ainnajib2002/superbot_ws/Schematic System/schematic.png

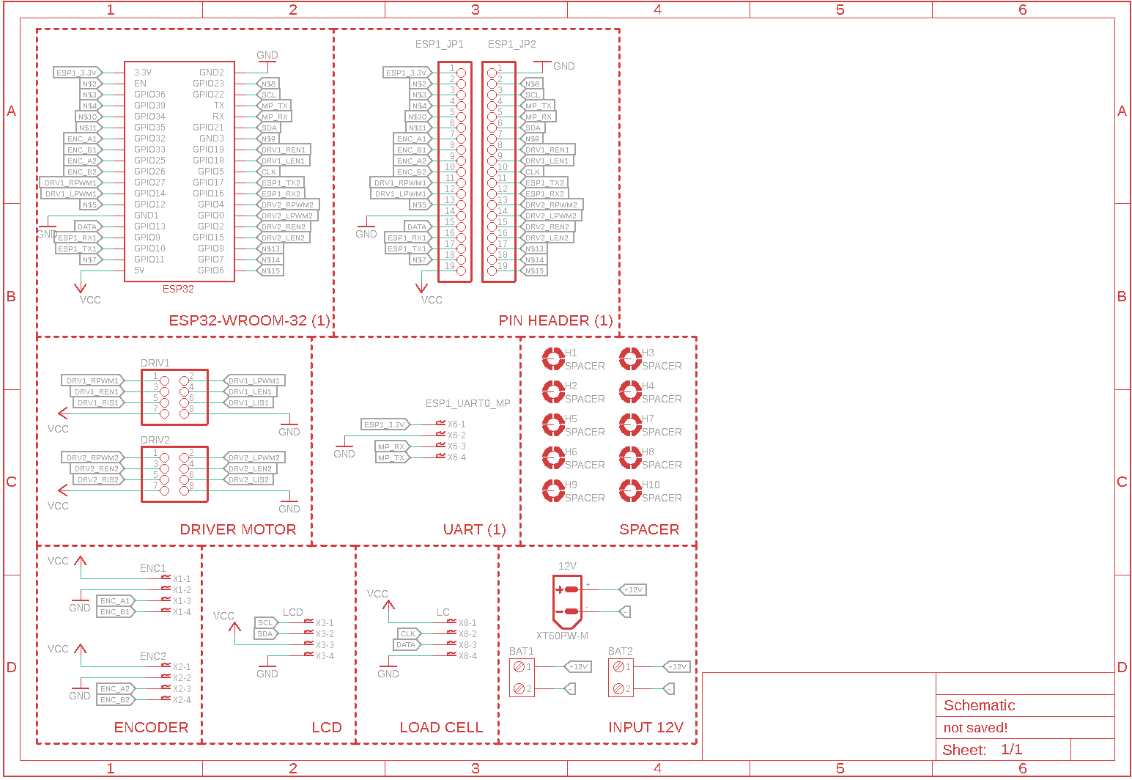
Schematic System/schematic.png
