ainnajib2002/superbot_ws/Schematic System/skematik_baru.png

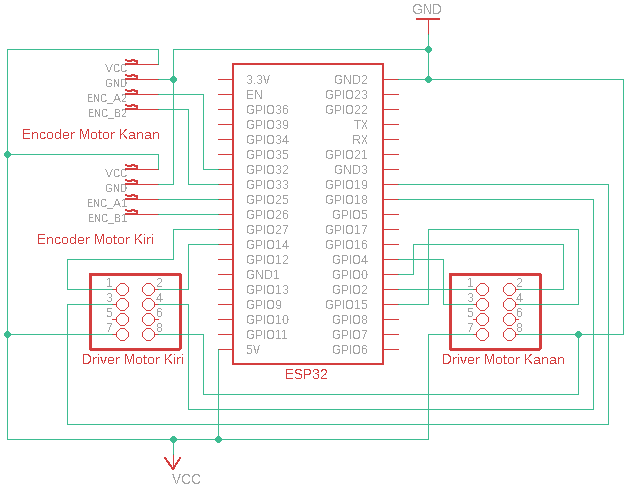
Schematic System/skematik_baru.png
