ainnajib2002/superbot_ws/Schematic System/tampak atas.png

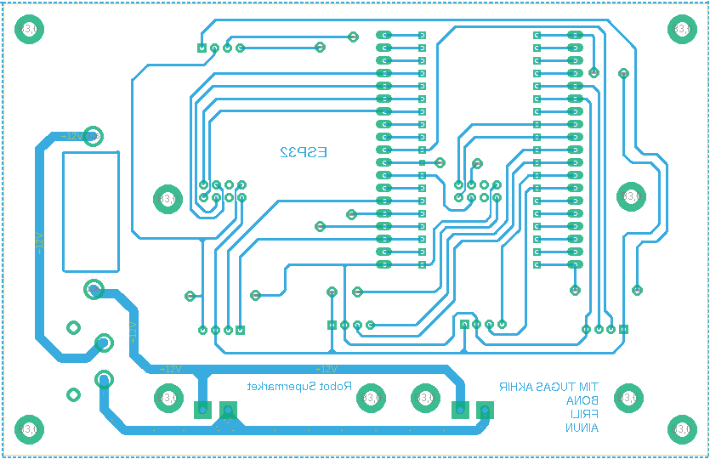
Schematic System/tampak atas.png
