ainnajib2002/superbot_ws/Schematic System/tampak bawah.png

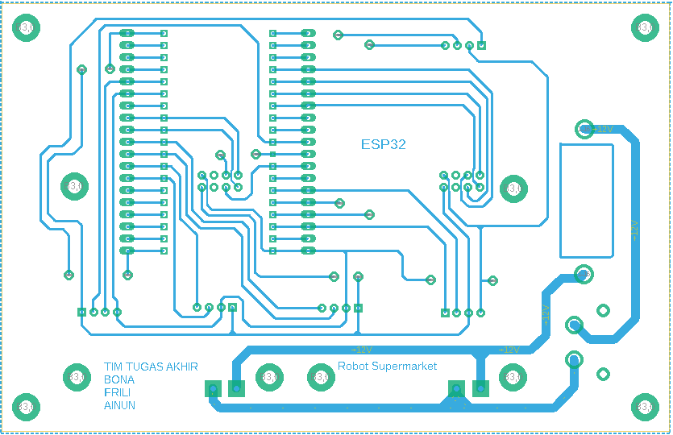
Schematic System/tampak bawah.png
