ainnajib2002/superbot_ws/src/superbot_core/superbot.png

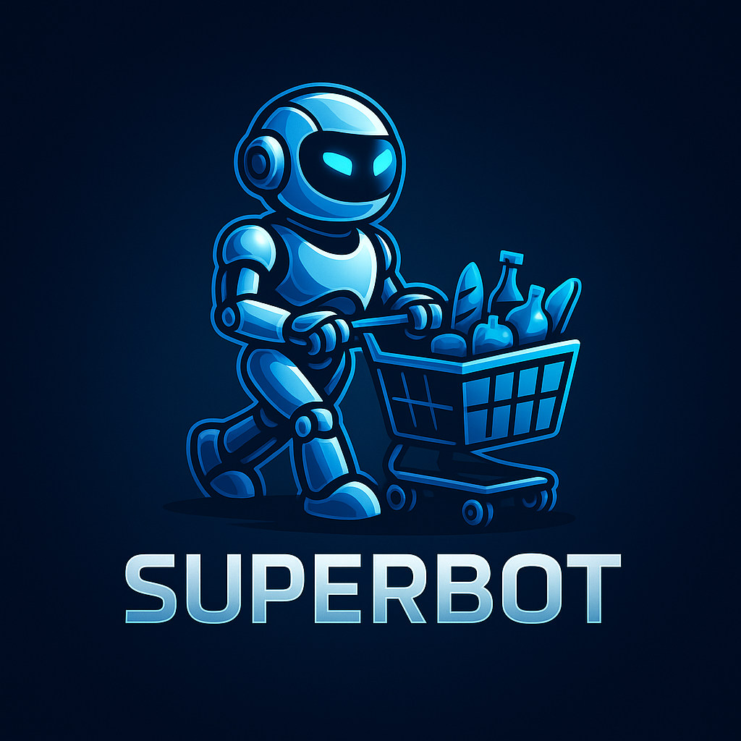
src/superbot_core/superbot.png
