ainnajib2002/superbot_ws/src/superbot_core/description/robot_core.xacro

<?xml version="1.0"?>

<robot xmlns:xacro="http://www.ros.org/wiki/xacro" >


<xacro:include filename="inertial_macros.xacro"/>

    <xacro:property name="chassis_length" value="0.51"/>
    <xacro:property name="chassis_width" value="0.51"/>
    <xacro:property name="chassis_height" value="0.22"/>
    <xacro:property name="chassis_mass" value="25.0"/>
    <xacro:property name="wheel_radius" value="0.05"/> <!--jari jari roda-->
    <xacro:property name="wheel_thickness" value="0.02"/>
    <xacro:property name="wheel_mass" value="0.1"/>
    <xacro:property name="wheel_offset_x" value="-0.03"/>
    <xacro:property name="wheel_offset_y" value="0.18"/>
    <xacro:property name="wheel_offset_z" value="0"/>
    <xacro:property name="caster_wheel_radius" value="0.05"/>
    <xacro:property name="caster_wheel_mass" value="0.1"/>
    <xacro:property name="caster_wheel_offset_x" value="0.1"/>
    <xacro:property name="caster_wheel_offset_z" value="${wheel_offset_z - wheel_radius + caster_wheel_radius}"/>

    <material name="white">
        <color rgba="1 1 1 1" />
    </material>

    <material name="orange">
        <color rgba="1 0.3 0.1 1"/>
    </material>

    <material name="blue">
        <color rgba="0.2 0.2 1 1"/>
    </material>

    <material name="black">
        <color rgba="0 0 0 1"/>
    </material>
    
    <material name="purple">
        <color rgba="0.5 0.0 0.5 1"/> <!-- ungu -->
    </material>
    
    <material name="green">
        <color rgba="0.0 1.0 0.0 1"/> <!-- hijau -->
    </material>
    
    <!-- BASE LINK -->

    <link name="base_link">
    </link>

    <!-- BASE_FOOTPRINT LINK -->

    <joint name="base_footprint_joint" type="fixed">
        <parent link="base_link"/>
        <child link="base_footprint"/>
        <origin xyz="0 0 0" rpy="0 0 0"/>
    </joint>

    <link name="base_footprint">
    </link>

    <!-- CHASSIS LINK -->

    <joint name="chassis_joint" type="fixed">
        <parent link="base_link"/>
        <child link="chassis"/>
        <origin xyz="-0.47 0 0"/>
    </joint>

    <link name="chassis">
        <visual>
            <origin xyz="0.255 0 0.11"/>
            <geometry>
                <box size="${chassis_length} ${chassis_width} ${chassis_height}"/> <!-- pxlxt kotak bawah-->
            </geometry>
            <material name="orange"/>
        </visual>
        <collision>
            <origin xyz="0.255 0 0.11"/>
            <geometry>
                <box size="${chassis_length} ${chassis_width} ${chassis_height}"/>
            </geometry>
        </collision>
        <xacro:inertial_box mass="${chassis_mass}" x="${chassis_length}" y="${chassis_width}" z="${chassis_height}">
            <origin xyz="0.255 0 0.11" rpy="0 0 0"/>
        </xacro:inertial_box>
    </link>

    <gazebo reference="chassis">
        <material>Gazebo/Orange</material>
    </gazebo>

    <!-- BODY LINK -->
    <joint name="body_joint" type="fixed">
        <parent link="chassis"/>
        <child link="body"/>
        <origin xyz="0.25 0 0.56"/> <!-- 0.22 (tinggi chassis) / 2 + 0.9 / 2 = 0.11 + 0.45 = 0.56 -->
    </joint>

    <link name="body">
        <visual>
            <origin xyz="0 0 -0.21"/>
            <geometry>
                <box size="0.45 0.5 0.27"/>
            </geometry>
            <material name="white"/>
        </visual>
        <collision>
            <origin xyz="0 0 0"/>
            <geometry>
                <box size="0.45 0.5 0.27"/>
            </geometry>
        </collision>
        <xacro:inertial_box mass="2.0" x="0.45" y="0.5" z="0.27">
            <origin xyz="0 0 0" rpy="0 0 0"/>
        </xacro:inertial_box>
    </link>

    <gazebo reference="body">
        <material>Gazebo/White</material>
    </gazebo>

    <!-- SMALL UPPER FRONT BODY LINK -->

    <joint name="small_upper_body_joint" type="fixed">
        <parent link="body"/>
        <child link="small_upper_body"/>
        <origin xyz="-0.23 0 0.22"/>
    </joint>

    <link name="small_upper_body">
        <visual>
            <geometry>
                <box size="0.05 0.15 0.1"/> <!-- panjang x, lebar y, tinggi z -->
            </geometry>
            <material name="purple"/>
        </visual>
        <collision>
            <geometry>
                <box size="0.05 0.15 0.1"/>
            </geometry>
        </collision>
        <xacro:inertial_box mass="0.1" x="0.05" y="0.15" z="0.1">
            <origin xyz="0 0 0" rpy="0 0 0"/>
        </xacro:inertial_box>
    </link>

    <gazebo reference="small_upper_body">
        <material>Gazebo/Purple</material>
    </gazebo>

    <!-- TIANG DEPAN LINK -->
    <joint name="tiang_depan_joint" type="fixed">
        <parent link="chassis"/>
        <child link="tiang_depan"/>
        <origin xyz="0.492 0 0.575" rpy="0 0 0"/> <!-- pojok kiri belakang atas chassis -->
    </joint>

    <link name="tiang_depan">
        <visual>
            <origin xyz="0 0 0.05"/> <!-- tengah vertikal dari tiang -->
            <geometry>
                <box size="0.037 0.51 0.815"/>
            </geometry>
            <material name="green"/>
        </visual>
        <collision>
            <origin xyz="0 0 0.05"/>
            <geometry>
                <box size="0.037 0.51 0.815"/>
            </geometry>
        </collision>
        <xacro:inertial_box mass="0.2" x="0.037" y="0.51" z="0.815">
            <origin xyz="0 0 0.05" rpy="0 0 0"/>
        </xacro:inertial_box>
    </link>

    <gazebo reference="tiang_depan">
        <material>Gazebo/Green</material>
    </gazebo>

    <!-- TIANG BELAKANG LINK -->
    <joint name="tiang_belakang_joint" type="fixed">
        <parent link="chassis"/>
        <child link="tiang_belakang"/>
        <origin xyz="0.021 0 0.425" rpy="0 0 0"/> <!-- pojok kiri belakang atas chassis -->
    </joint>

    <link name="tiang_belakang">
        <visual>
            <origin xyz="0 0 0.05"/> <!-- tengah vertikal dari tiang -->
            <geometry>
                <box size="0.045 0.51 0.51"/>
            </geometry>
            <material name="green"/>
        </visual>
        <collision>
            <origin xyz="0 0 0.05"/>
            <geometry>
                <box size="0.045 0.51 0.51"/>
            </geometry>
        </collision>
        <xacro:inertial_box mass="0.2" x="0.045" y="0.51" z="0.51">
            <origin xyz="0 0 0.05" rpy="0 0 0"/>
        </xacro:inertial_box>
    </link>

    <gazebo reference="tiang_belakang">
        <material>Gazebo/Green</material>
    </gazebo>
    
    <!-- LEFT WHEEL LINK -->

    <joint name="left_wheel_joint" type="continuous">
        <parent link="base_link"/>
        <child link="left_wheel"/>
        <origin xyz="${wheel_offset_x} ${wheel_offset_y} ${wheel_offset_z}" rpy="-${pi/2} 0 -${pi/4}" /> <!-- rotasi roda-->
        <axis xyz="0 0 1"/>
    </joint>

    <link name="left_wheel">
        <visual>
            <geometry>
                <cylinder radius="${wheel_radius}" length="${wheel_thickness}"/>
            </geometry>
            <material name="blue"/>
        </visual>
        <collision>
            <geometry>
                <cylinder radius="${wheel_radius}" length="${wheel_thickness}"/>
            </geometry>
        </collision>
        <xacro:inertial_cylinder mass="${wheel_mass}" length="${wheel_thickness}" radius="${wheel_radius}">
            <origin xyz="0 0 0" rpy="0 0 0"/>
        </xacro:inertial_cylinder>
    </link>

    <gazebo reference="left_wheel">
        <material>Gazebo/Blue</material>
    </gazebo>

    <!-- RIGHT WHEEL LINK -->

    <joint name="right_wheel_joint" type="continuous">
        <parent link="base_link"/>
        <child link="right_wheel"/>
        <origin xyz="${wheel_offset_x} -${wheel_offset_y} ${wheel_offset_z}" rpy="${pi/2} 0 ${pi/4}" /> <!--{pi/4} -->
        <axis xyz="0 0 -1"/>
    </joint>

    <link name="right_wheel">
        <visual>
            <geometry>
                <cylinder radius="${wheel_radius}" length="${wheel_thickness}"/>
            </geometry>
            <material name="blue"/>
        </visual>
        <collision>
            <geometry>
                <cylinder radius="${wheel_radius}" length="${wheel_thickness}"/>
            </geometry>
        </collision>
        <xacro:inertial_cylinder mass="${wheel_mass}" length="${wheel_thickness}" radius="${wheel_radius}">
            <origin xyz="0 0 0" rpy="0 0 0"/>
        </xacro:inertial_cylinder>
    </link>

    <gazebo reference="right_wheel">
        <material>Gazebo/Blue</material>
    </gazebo>


    <!-- KIRI CASTER WHEEL LINK -->

    <joint name="left_caster_wheel_joint" type="fixed">
        <parent link="chassis"/>
        <child link="left_caster_wheel"/>
        <origin xyz="${caster_wheel_offset_x} ${wheel_offset_y} ${caster_wheel_offset_z}" rpy="-${pi/2} 0 0"/> <!-- orientasi silinder horizontal -->
    </joint>

    <link name="left_caster_wheel">
        <visual>
            <geometry>
                <cylinder radius="${caster_wheel_radius}" length="${wheel_thickness}"/>
            </geometry>
            <material name="black"/>
        </visual>
        <collision>
            <geometry>
                <cylinder radius="${caster_wheel_radius}" length="${wheel_thickness}"/>
            </geometry>
        </collision>
        <xacro:inertial_cylinder mass="${caster_wheel_mass}" length="${wheel_thickness}" radius="${caster_wheel_radius}">
            <origin xyz="0 0 0" rpy="0 0 0"/>
        </xacro:inertial_cylinder>
    </link>

    <gazebo reference="left_caster_wheel">
        <material>Gazebo/Black</material>
        <mu1 value="0.001"/>
        <mu2 value="0.001"/>
    </gazebo>


    <!-- KANAN CASTER WHEEL LINK -->

    <joint name="right_caster_wheel_joint" type="fixed">
        <parent link="chassis"/>
        <child link="right_caster_wheel"/>
        <origin xyz="${caster_wheel_offset_x} -${wheel_offset_y} ${caster_wheel_offset_z}" rpy="-${pi/2} 0 0"/> <!-- orientasi silinder horizontal -->
    </joint>

    <link name="right_caster_wheel">
        <visual>
            <geometry>
                <cylinder radius="${caster_wheel_radius}" length="${wheel_thickness}"/>
            </geometry>
            <material name="black"/>
        </visual>
        <collision>
            <geometry>
                <cylinder radius="${caster_wheel_radius}" length="${wheel_thickness}"/>
            </geometry>
        </collision>
        <xacro:inertial_cylinder mass="${caster_wheel_mass}" length="${wheel_thickness}" radius="${caster_wheel_radius}">
            <origin xyz="0 0 0" rpy="0 0 0"/>
        </xacro:inertial_cylinder>
    </link>

    <gazebo reference="right_caster_wheel">
        <material>Gazebo/Black</material>
        <mu1 value="0.001"/>
        <mu2 value="0.001"/>
    </gazebo>    

</robot>
