ainnajib2002/superbot_ws/Schematic System/Schematic.brd

## EAGLE design Schematic System/Schematic.brd (2025-08-28)

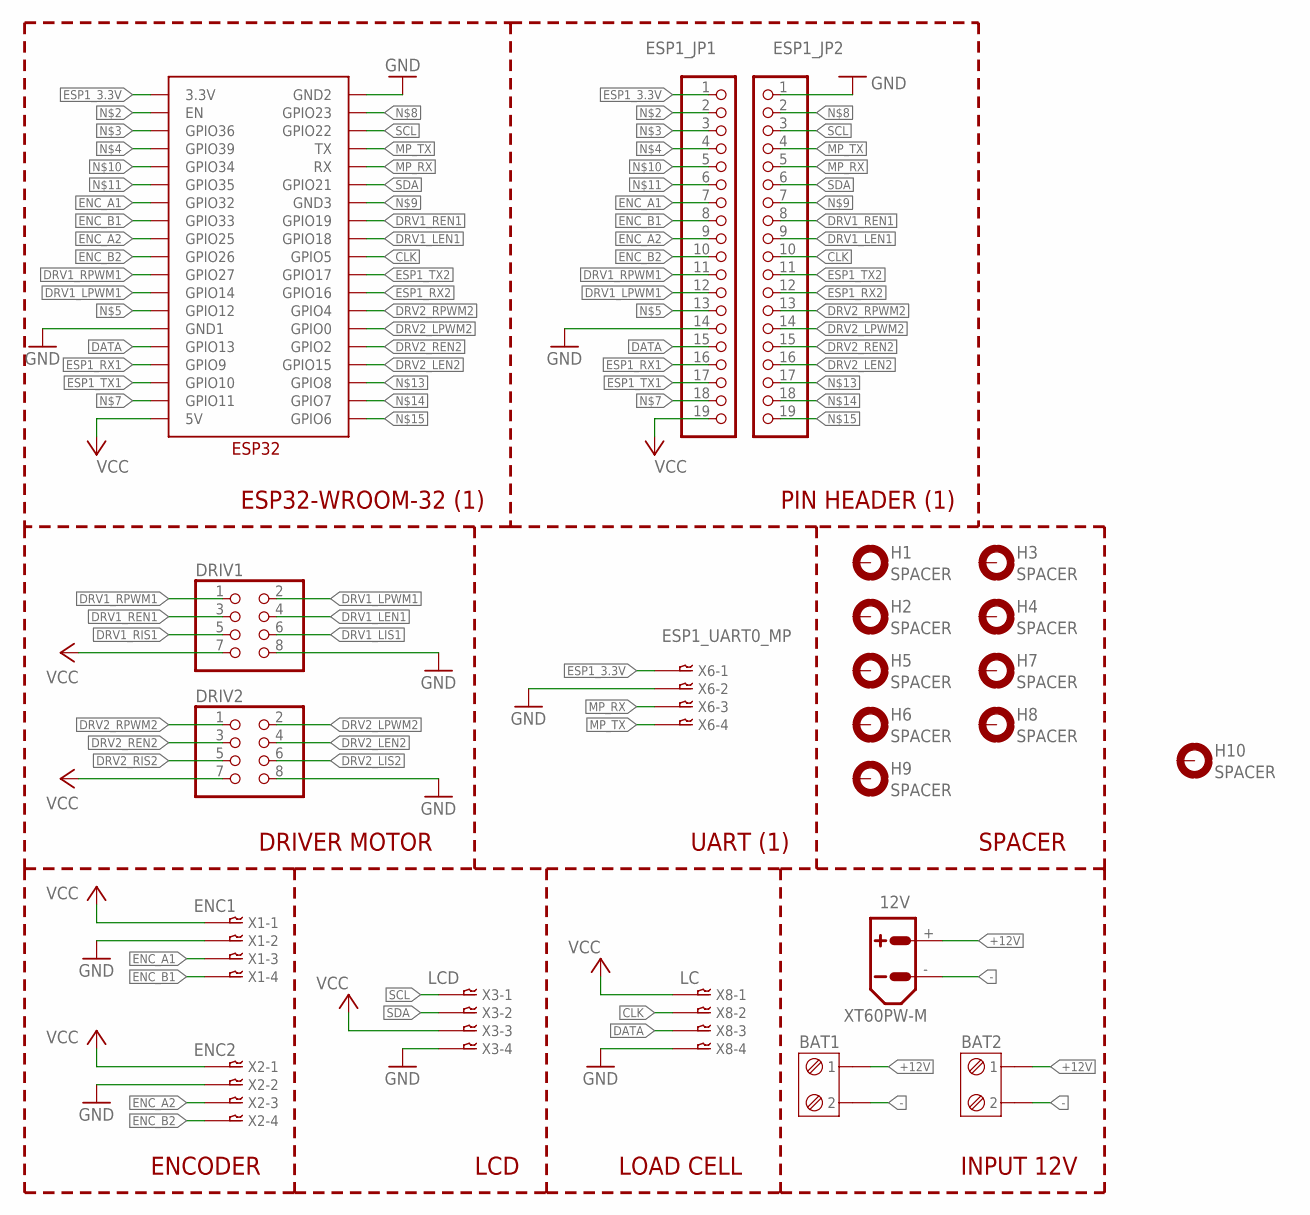
[picture p41: schematic Schematic.sch]

Parts:
12V: XT60PW-M
BAT1, BAT2: TERMINAL-BLOK-2P; TERMINAL_BLOK_2P
DRIV1, DRIV2: PINHD-2X4; 2X04
ESP1_JP1, ESP1_JP2: PINHD-1X19; 1X19
H1, H2, H3, H4, H5, H6, H7, H8, H9, H10: SPACER; 3,0-PAD
U$1: ESP32_GRBL
X1: ENC1; B4B-XH
X2: ENC2; B4B-XH
X3: LCD; B4B-XH
X6: ESP1_UART0_MP; B4B-XH
X8: LC; B4B-XH

Connections:
+12V: 12V.+, BAT1.1, BAT2.1
-: 12V.-, BAT1.2, BAT2.2
CLK: ESP1_JP2.10, U$1.GPIO5, X8.P$2
DATA: ESP1_JP1.15, U$1.GPIO13, X8.P$3
DRV1_LEN1: DRIV1.4, ESP1_JP2.9, U$1.GPIO18
DRV1_LIS1: DRIV1.6
DRV1_LPWM1: DRIV1.2, ESP1_JP1.12, U$1.GPIO14
DRV1_REN1: DRIV1.3, ESP1_JP2.8, U$1.GPIO19
DRV1_RIS1: DRIV1.5
DRV1_RPWM1: DRIV1.1, ESP1_JP1.11, U$1.GPIO27
DRV2_LEN2: DRIV2.4, ESP1_JP2.16, U$1.GPIO15
DRV2_LIS2: DRIV2.6
DRV2_LPWM2: DRIV2.2, ESP1_JP2.14, U$1.GPIO0
DRV2_REN2: DRIV2.3, ESP1_JP2.15, U$1.GPIO2
DRV2_RIS2: DRIV2.5
DRV2_RPWM2: DRIV2.1, ESP1_JP2.13, U$1.GPIO4
ENC_A1: ESP1_JP1.7, U$1.GPIO32, X1.P$3
ENC_A2: ESP1_JP1.9, U$1.GPIO25, X2.P$3
ENC_B1: ESP1_JP1.8, U$1.GPIO33, X1.P$4
ENC_B2: ESP1_JP1.10, U$1.GPIO26, X2.P$4
ESP1_3.3V: ESP1_JP1.1, U$1.3.3V, X6.P$1
ESP1_RX1: ESP1_JP1.16, U$1.GPIO9
ESP1_RX2: ESP1_JP2.12, U$1.GPIO16
ESP1_TX1: ESP1_JP1.17, U$1.GPIO10
ESP1_TX2: ESP1_JP2.11, U$1.GPIO17
GND: DRIV1.8, DRIV2.8, ESP1_JP1.14, ESP1_JP2.1, U$1.GND1, U$1.GND2, X1.P$2, X2.P$2, X3.P$4, X6.P$2, X8.P$4
MP_RX: ESP1_JP2.5, U$1.RX, X6.P$3
MP_TX: ESP1_JP2.4, U$1.TX, X6.P$4
unnamed: ESP1_JP1.2, U$1.EN
unnamed: ESP1_JP1.3, U$1.GPIO36
unnamed: ESP1_JP1.4, U$1.GPIO39
unnamed: ESP1_JP1.13, U$1.GPIO12
unnamed: ESP1_JP1.18, U$1.GPIO11
unnamed: ESP1_JP2.2, U$1.GPIO23
unnamed: ESP1_JP2.7, U$1.GND3
unnamed: ESP1_JP1.5, U$1.GPIO34
unnamed: ESP1_JP1.6, U$1.GPIO35
unnamed: ESP1_JP2.17, U$1.GPIO8
unnamed: ESP1_JP2.18, U$1.GPIO7
unnamed: ESP1_JP2.19, U$1.GPIO6
SCL: ESP1_JP2.3, U$1.GPIO22, X3.P$1
SDA: ESP1_JP2.6, U$1.GPIO21, X3.P$2
VCC: DRIV1.7, DRIV2.7, ESP1_JP1.19, U$1.5V, X1.P$1, X2.P$1, X3.P$3, X8.P$1

Notes on the sheet:
ESP32-WROOM-32 (1)
PIN HEADER (1)
DRIVER MOTOR
UART (1)
SPACER
INPUT 12V
ENCODER
LCD
LOAD CELL

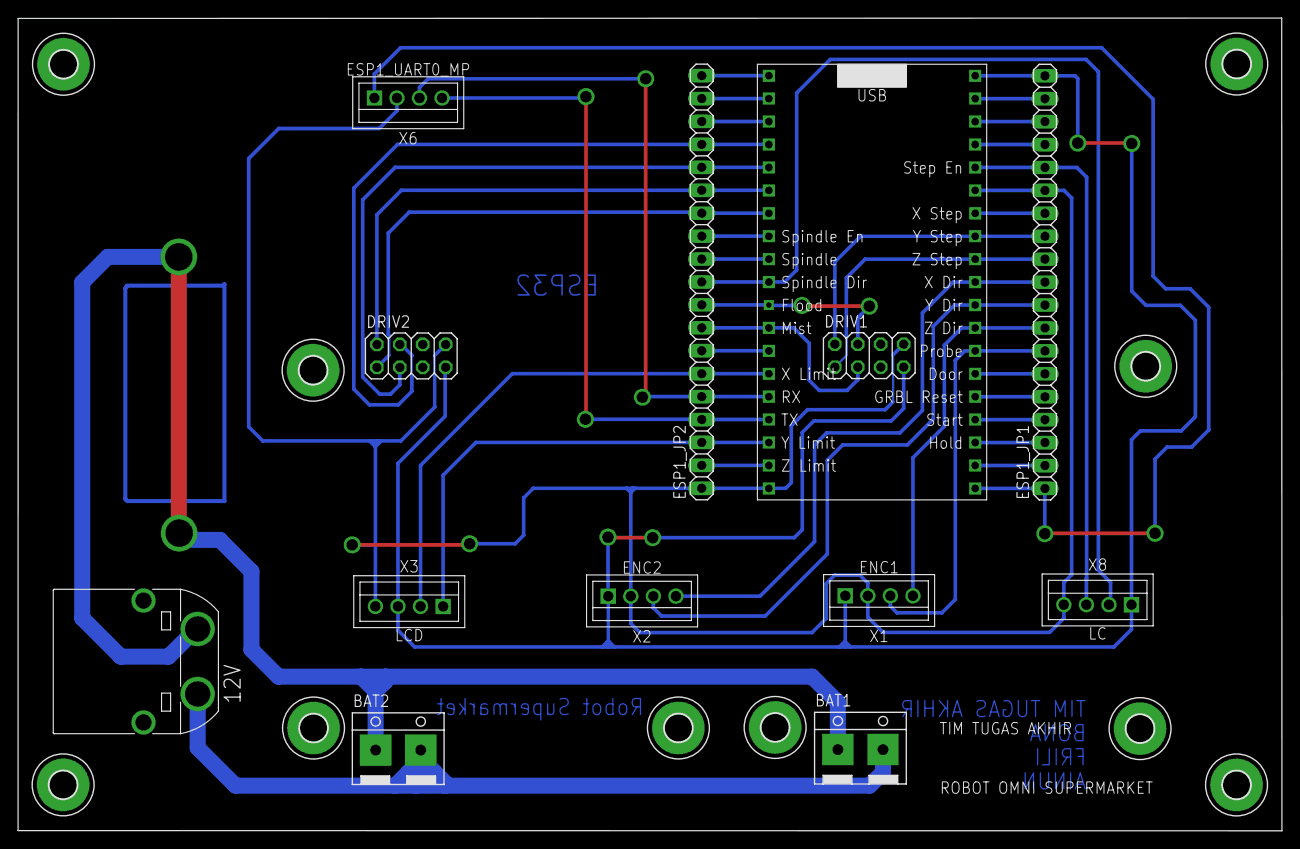
[picture p42: board Schematic.brd from above]

Board: 2 copper layers, 140.0 x 90.0 mm, 23 parts (0 on the bottom side), 39 nets.
