ainnajib2002/superbot_ws/src/superbot_hardware/config/superbot_controllers.yaml

controller_manager:
  ros__parameters:
    update_rate: 80  # Hz

    joint_state_broadcaster:
      type: joint_state_broadcaster/JointStateBroadcaster

    diffbot_base_controller:
      type: diff_drive_controller/DiffDriveController

diffbot_base_controller:
  ros__parameters:
    left_wheel_names: ["left_wheel_joint"]
    right_wheel_names: ["right_wheel_joint"]

    # wheel_separation: 0.10
    # #wheels_per_side: 1  # actually 2, but both are controlled by 1 signal
    # wheel_radius: 0.015
    wheel_separation: 0.30 #jarak antar roda 30cm
    wheel_radius: 0.05 #jari jari roda 5cm

    wheel_separation_multiplier: 1.0
    left_wheel_radius_multiplier: 1.1
    right_wheel_radius_multiplier: -1.1

    publish_rate: 50.0
    odom_frame_id: odom
    base_frame_id: base_link
    pose_covariance_diagonal : [0.001, 0.001, 0.001, 0.001, 0.001, 0.01]
    twist_covariance_diagonal: [0.001, 0.001, 0.001, 0.001, 0.001, 0.01]

    open_loop: false
    enable_odom_tf: true

    cmd_vel_timeout: 0.5
    publish_limited_velocity: true
    use_stamped_vel: false
    #velocity_rolling_window_size: 10

    linear.x.has_velocity_limits: true
    linear.x.has_acceleration_limits: true
    linear.x.has_jerk_limits: false
    linear.x.max_velocity: 0.25     # m/s
    linear.x.min_velocity: -0.25       
    linear.x.max_acceleration: 1.0    # m/s^2
    linear.x.min_acceleration: -1.0
    linear.x.max_jerk: 0.0            # m/s^3
    linear.x.min_jerk: 0.0            

    angular.z.has_velocity_limits: true
    angular.z.has_acceleration_limits: true
    angular.z.has_jerk_limits: false
    angular.z.max_velocity: 3.14        # rad/s
    angular.z.min_velocity: -3.14
    angular.z.max_acceleration: 1.28    # rad/s^2
    angular.z.min_acceleration: -1.28
    angular.z.max_jerk: 0.0             # rad/s^3
    angular.z.min_jerk: 0.0
