ainnajib2002/superbot_ws/src/superbot_core/txt/cgatparamsteb.yaml

amcl:
  ros__parameters:
    use_sim_time: False
    alpha1: 0.2
    alpha2: 0.2
    alpha3: 0.2
    alpha4: 0.2
    alpha5: 0.2
    base_frame_id: "base_footprint"
    beam_skip_distance: 0.5
    beam_skip_error_threshold: 0.9
    beam_skip_threshold: 0.3
    do_beamskip: false
    global_frame_id: "map"
    lambda_short: 0.1
    laser_likelihood_max_dist: 2.0
    laser_max_range: 100.0
    laser_min_range: -1.0
    laser_model_type: "likelihood_field"
    max_beams: 60
    max_particles: 3000 #2000
    min_particles: 1000 #500
    odom_frame_id: "odom"
    pf_err: 0.05 #Toleransi error rata-rata (0.05 artinya 5 cm) untuk menentukan jumlah partikel.
    pf_z: 0.99
    recovery_alpha_fast: 0.0
    recovery_alpha_slow: 0.0
    resample_interval: 1
    robot_model_type: "differential"
    save_pose_rate: 0.5
    sigma_hit: 0.2
    tf_broadcast: true
    transform_tolerance: 1.0
    update_min_a: 0.02 ##jika robot telah berputar sejauh x.xmeter.
    update_min_d: 0.025 # (2.5 cm)jika robot telah bergerak sejauh x.xm eter.
    z_hit: 0.5
    z_max: 0.05
    z_rand: 0.5
    z_short: 0.05
    scan_topic: scan
    set_initial_pose: true
    # always_reset_initial_pose: false
    # first_map_only: false
    initial_pose:
      x: 0.0
      y: 0.0
      z: 0.0
      yaw: 0.0

amcl_map_client:
  ros__parameters:
    use_sim_time: False

amcl_rclcpp_node:
  ros__parameters:
    use_sim_time: False

bt_navigator:
  ros__parameters:
    use_sim_time: False
    global_frame: map
    robot_base_frame: base_link
    odom_topic: /odom
    enable_groot_monitoring: True
    groot_zmq_publisher_port: 1666
    groot_zmq_server_port: 1667
    bt_loop_duration: 0.025
    default_server_timeout: 10 #Timeout dari BT (Behavior Tree)
    wait_for_service_timeout: 1000  # 1 detik
    action_server_result_timeout: 100.0  # menit
    default_bt_xml_filename: "/home/orin/superbot_ws/src/navigation2/nav2_bt_navigator/behavior_trees/navigate_w_replanning_and_recovery.xml"
    # navigators: ["navigate_to_pose", "navigate_through_poses"]
    # navigate_to_pose:/opt/ros/foxy/share/nav2_bt_navigator/behavior_trees/navigate_w_replanning_and_recovery.xml 
    #   plugin: "nav2_bt_navigator::NavigateToPoseNavigator"
    # navigate_through_poses:
    #   plugin: "nav2_bt_navigator::NavigateThroughPosesNavigator"
    plugin_lib_names:
    - nav2_compute_path_to_pose_action_bt_node
    - nav2_follow_path_action_bt_node
    - nav2_back_up_action_bt_node
    - nav2_spin_action_bt_node
    - nav2_wait_action_bt_node
    - nav2_clear_costmap_service_bt_node
    - nav2_is_stuck_condition_bt_node
    - nav2_goal_reached_condition_bt_node
    - nav2_goal_updated_condition_bt_node
    - nav2_initial_pose_received_condition_bt_node
    - nav2_reinitialize_global_localization_service_bt_node
    - nav2_rate_controller_bt_node
    - nav2_distance_controller_bt_node
    - nav2_speed_controller_bt_node
    - nav2_truncate_path_action_bt_node
    - nav2_goal_updater_node_bt_node
    - nav2_recovery_node_bt_node
    - nav2_pipeline_sequence_bt_node
    - nav2_round_robin_node_bt_node
    - nav2_transform_available_condition_bt_node
    - nav2_time_expired_condition_bt_node
    - nav2_distance_traveled_condition_bt_node
    - nav2_navigate_to_pose_action_bt_node

bt_navigator_rclcpp_node:
  ros__parameters:
    use_sim_time: False

controller_server:
  ros__parameters:
    odom_topic: /odom
    use_sim_time: True
    controller_frequency: 5.0
    controller_plugin_types: ["teb_local_planner::TebLocalPlannerROS"]
    controller_plugins: ["FollowPath"]
    
    # Progress checker parameters
    progress_checker:
      plugin: "nav2_controller::SimpleProgressChecker"
      required_movement_radius: 0.2
      movement_time_allowance: 40.0  # Batas waktu maksimum (dalam detik) yang diizinkan untuk robot bergerak sebelum dianggap gagal.
    
    # Goal checker parameters
    goal_checker:
      plugin: "nav2_controller::SimpleGoalChecker"
      xy_goal_tolerance: 0.15
      yaw_goal_tolerance: 0.15
      stateful: True

    # TEB parameters
    FollowPath:
      plugin: teb_local_planner::TebLocalPlannerROS

      teb_autosize: 1.0
      dt_ref: 0.3
      dt_hysteresis: 0.1
      max_samples: 500
      global_plan_overwrite_orientation: False
      allow_init_with_backwards_motion: False
      max_global_plan_lookahead_dist: 3.0
      global_plan_viapoint_sep: 0.3
      global_plan_prune_distance: 1.0
      exact_arc_length: False
      feasibility_check_no_poses: 2
      publish_feedback: False

      # Robot
      max_vel_x: 0.26
      max_vel_theta: 1.0 
      acc_lim_x: 2.5
      acc_lim_theta: 3.2

      footprint_model: 
        type: "circular"
        radius: 0.17 # for type "circular"

      # Goal Tolerance
      free_goal_vel: False

      # Obstacles
      min_obstacle_dist: 0.27
      inflation_dist: 0.6
      include_costmap_obstacles: True
      costmap_obstacles_behind_robot_dist: 1.0
      obstacle_poses_affected: 15

      dynamic_obstacle_inflation_dist: 0.6
      include_dynamic_obstacles: True 

      costmap_converter_plugin: "costmap_converter::CostmapToPolygonsDBSMCCH"
      costmap_converter_spin_thread: True
      costmap_converter_rate: 5

      # Optimization
      no_inner_iterations: 5
      no_outer_iterations: 4
      optimization_activate: True
      optimization_verbose: False
      penalty_epsilon: 0.1
      obstacle_cost_exponent: 4.0
      weight_max_vel_x: 0.5
      weight_max_vel_theta: 0.5
      weight_acc_lim_x: 0.5
      weight_acc_lim_theta: 10.5
      weight_kinematics_nh: 1000.0
      weight_kinematics_forward_drive: 3.0
      weight_kinematics_turning_radius: 1.0
      weight_optimaltime: 1.0 # must be > 0
      weight_shortest_path: 0.0
      weight_obstacle: 100.0
      weight_inflation: 0.2
      weight_dynamic_obstacle: 10.0 # not in use yet
      weight_dynamic_obstacle_inflation: 0.2
      weight_viapoint: 50.0
      weight_adapt_factor: 2.0

      # Homotopy Class Planner
      enable_homotopy_class_planning: True
      enable_multithreading: True
      max_number_classes: 4
      selection_cost_hysteresis: 5.0
      selection_prefer_initial_plan: 1.0
      selection_obst_cost_scale: 1.0
      selection_alternative_time_cost: True

      roadmap_graph_no_samples: 15
      roadmap_graph_area_width: 5.0
      roadmap_graph_area_length_scale: 1.0
      h_signature_prescaler: 0.5
      h_signature_threshold: 0.1
      obstacle_heading_threshold: 0.45
      switching_blocking_period: 0.0
      viapoints_all_candidates: True
      delete_detours_backwards: True
      max_ratio_detours_duration_best_duration: 3.0
      visualize_hc_graph: False
      visualize_with_time_as_z_axis_scale: 0.0

      # Recovery
      shrink_horizon_backup: True
      shrink_horizon_min_duration: 10.0
      oscillation_recovery: True
      oscillation_v_eps: 0.1
      oscillation_omega_eps: 0.1
      oscillation_recovery_min_duration: 10.0
      oscillation_filter_duration: 10.0


controller_server_rclcpp_node:
  ros__parameters:
    use_sim_time: False

# planner_server:
#   ros__parameters:
#     use_sim_time: False
#     planner_plugins: ["GridBased"]
#     GridBased:
#       plugin: "nav2_navfn_planner/NavfnPlanner"

local_costmap:
  local_costmap:
    ros__parameters:
      update_frequency: 5.0
      publish_frequency: 2.0
      global_frame: odom
      robot_base_frame: base_link
      use_sim_time: False
      rolling_window: true
      width: 5
      height: 5
      resolution: 0.05
      robot_radius: 0.42 # ukuran robot (untuk memastikan robot tidak menabrak rintangan) 52 cm
      plugins: ["static_layer","voxel_layer", "inflation_layer"]
      inflation_layer:
        plugin: "nav2_costmap_2d::InflationLayer"
        cost_scaling_factor: 6.5     # cukup agresif tapi tidak berlebihan
        inflation_radius: 0.87        # aman untuk robot sedang, jarak menghindar cukup
      voxel_layer:
        plugin: "nav2_costmap_2d::VoxelLayer"
        enabled: True
        publish_voxel_map: True
        origin_z: 0.0
        z_resolution: 0.05
        z_voxels: 16
        max_obstacle_height: 2.0
        mark_threshold: 0
        observation_sources: scan
        scan:
          topic: /scan
          max_obstacle_height: 2.0
          clearing: True
          marking: True
          data_type: "LaserScan"
      static_layer:
        plugin: "nav2_costmap_2d::StaticLayer"
        map_subscribe_transient_local: True
      always_send_full_costmap: True
  local_costmap_client:
    ros__parameters:
      use_sim_time: False
  local_costmap_rclcpp_node:
    ros__parameters:
      use_sim_time: False

global_costmap:
  global_costmap:
    ros__parameters:
      update_frequency: 5.0
      publish_frequency: 2.0
      global_frame: map
      robot_base_frame: base_link
      use_sim_time: False
      robot_radius: 0.52 #ukuran robot
      resolution: 0.05
      track_unknown_space: true
      plugins: ["static_layer", "obstacle_layer", "inflation_layer"]
      obstacle_layer:
        plugin: "nav2_costmap_2d::ObstacleLayer"
        enabled: True
        observation_sources: scan
        scan:
          topic: /scan
          max_obstacle_height: 2.0
          clearing: True
          marking: True
          data_type: "LaserScan"
      static_layer:
        plugin: "nav2_costmap_2d::StaticLayer"
        map_subscribe_transient_local: True
      inflation_layer:
        plugin: "nav2_costmap_2d::InflationLayer"
        cost_scaling_factor: 6.5     # cukup agresif tapi tidak berlebihan
        inflation_radius: 0.87        # aman untuk robot sedang, jarak menghindar cukup
      always_send_full_costmap: True
  global_costmap_client:
    ros__parameters:
      use_sim_time: False
  global_costmap_rclcpp_node:
    ros__parameters:
      use_sim_time: False

map_server:
  ros__parameters:
    use_sim_time: False
    yaml_filename: /home/orin/superbot_ws/src/superbot_core/maps/my_map2_save.yaml

map_saver:
  ros__parameters:
    use_sim_time: False
    save_map_timeout: 5000
    free_thresh_default: 0.25
    occupied_thresh_default: 0.65
    map_subscribe_transient_local: False

planner_server:
  ros__parameters:
    expected_planner_frequency: 10.0
    use_sim_time: False
    planner_plugins: ["GridBased"]
    GridBased:
      plugin: "nav2_navfn_planner/NavfnPlanner"
      tolerance: 0.2
      use_astar: true
      allow_unknown: true

planner_server_rclcpp_node:
  ros__parameters:
    use_sim_time: False

recoveries_server:
  ros__parameters:
    costmap_topic: local_costmap/costmap_raw
    footprint_topic: local_costmap/published_footprint
    global_costmap_topic: global_costmap/costmap_raw
    global_footprint_topic: global_costmap/published_footprint
    cycle_frequency: 20.0
    recovery_plugins: ["spin", "back_up", "wait"]
    spin:
      plugin: "nav2_recoveries/Spin"
    back_up:
      plugin: "nav2_recoveries/BackUp"
    wait:
      plugin: "nav2_recoveries/Wait"
    global_frame: odom
    robot_base_frame: base_link
    transform_timeout: 1.0
    use_sim_time: False
    simulate_ahead_time: 2.0
    max_rotational_vel: 1.0
    min_rotational_vel: 0.4
    rotational_acc_lim: 3.2

robot_state_publisher:
  ros__parameters:
    use_sim_time: False

waypoint_follower:
  ros__parameters:
    loop_rate: 20
    stop_on_failure: false
    waypoint_task_executor_plugin: "wait_at_waypoint"   
    wait_at_waypoint:
      plugin: "nav2_waypoint_follower::WaitAtWaypoint"
      enabled: True
      waypoint_pause_duration: 200
