ainnajib2002/superbot_ws/Firmware/commands.h

/* Define single-letter commands that will be sent by the PC over the
   serial link.
*/

#ifndef COMMANDS_H
#define COMMANDS_H

#define ANALOG_READ     'a'
#define GET_BAUDRATE    'b'
#define PIN_MODE        'c'
#define DIGITAL_READ    'd'
#define READ_ENCODERS   'e'
#define READ_LOADCELL   'f'
#define RESET_LOADCELL  't'
#define SET_CALIBRATION 'k'
#define READ_RAWLOADCELL 'g'
#define MOTOR_SPEEDS    'm'
#define MOTOR_RAW_PWM   'o'
#define PING            'p'
#define RESET_ENCODERS  'r'
#define SERVO_WRITE     's'
#define SERVO_READ      'l'
#define UPDATE_PID      'u'
#define DIGITAL_WRITE   'w'
#define ANALOG_WRITE    'x'
#define LEFT             0
#define RIGHT            1




#endif
