ainnajib2002/superbot_ws/src/superbot_core/launch/rplidar.launch.py

import os
from launch import LaunchDescription
from launch_ros.actions import Node

def generate_launch_description():

    return LaunchDescription([

        Node(
            package='rplidar_ros',
            executable='rplidar_composition',
            output='screen',
            parameters=[{
                'serial_port': '/dev/serial/by-path/platform-3610000.xhci-usb-0:2.2.1:1.0-port0', #serial
                'frame_id': 'laser_frame',
                'angle_compensate': True,
                'scan_mode': 'Standard'
            }]
        )
    ])
