ainnajib2002/superbot_ws/src/superbot_core/launch/launch_sim.launch.py

import os

from ament_index_python.packages import get_package_share_directory
from launch import LaunchDescription
from launch.actions import DeclareLaunchArgument, IncludeLaunchDescription, RegisterEventHandler
from launch.event_handlers import OnProcessExit
from launch.launch_description_sources import PythonLaunchDescriptionSource
from launch.substitutions import LaunchConfiguration
from launch_ros.actions import Node

def generate_launch_description():
    package_name = 'superbot_core'

    # Launch arguments
    use_sim_time = LaunchConfiguration('use_sim_time')
    params_file = LaunchConfiguration('params_file')

    declare_use_sim_time_cmd = DeclareLaunchArgument(
        'use_sim_time',
        default_value='true',
        description='Use simulation time'
    )

    declare_params_file_cmd = DeclareLaunchArgument(
        'params_file',
        default_value=os.path.join(get_package_share_directory(package_name), 'config', 'mapper_params_slam.yaml'),
        description='Full path to the ROS2 parameters file to use for the slam_toolbox node'
    )

    # RSP (Robot State Publisher, URDF, etc.)
    rsp = IncludeLaunchDescription(
        PythonLaunchDescriptionSource(os.path.join(get_package_share_directory(package_name), 'launch', 'rsp.launch.py')),
        launch_arguments={'use_sim_time': use_sim_time, 'use_ros2_control': 'true'}.items()
    )

    # Joystick
    joystick = IncludeLaunchDescription(
        PythonLaunchDescriptionSource(os.path.join(get_package_share_directory(package_name), 'launch', 'joystick.launch.py')),
        launch_arguments={'use_sim_time': use_sim_time}.items()
    )

    # Twist Mux
    twist_mux_params = os.path.join(get_package_share_directory(package_name), 'config', 'twist_mux.yaml')
    twist_mux = Node(
        package='twist_mux',
        executable='twist_mux',
        parameters=[twist_mux_params, {'use_sim_time': use_sim_time}],
        remappings=[('/cmd_vel_out', '/diff_cont/cmd_vel_unstamped')]
    )

    # Gazebo
    gazebo_params_file = os.path.join(get_package_share_directory(package_name), 'config', 'gazebo_params.yaml')
    gazebo = IncludeLaunchDescription(
        PythonLaunchDescriptionSource(os.path.join(get_package_share_directory('gazebo_ros'), 'launch', 'gazebo.launch.py')),
        launch_arguments={'extra_gazebo_args': '--ros-args --params-file ' + gazebo_params_file}.items()
    )

    # Node untuk spawn robot ke Gazebo
    spawn_entity = Node(
        package='gazebo_ros',
        executable='spawn_entity.py',
        arguments=['-topic', 'robot_description', '-entity', 'my_bot'],
        output='screen'
    )

    # Definisikan spawner controller (JANGAN dijalankan langsung)
    diff_drive_spawner = Node(
        package='controller_manager',
        executable='spawner.py',
        arguments=['diff_cont'],
    )

    joint_broad_spawner = Node(
        package='controller_manager',
        executable='spawner.py',
        arguments=['joint_broad'],
    )
    
    # ================== PERUBAHAN UTAMA ADA DI SINI ==================
    # Buat event handler untuk menunda spawner
    # Ini akan menunggu sampai 'spawn_entity' selesai, baru menjalankan spawner
    delayed_spawners = RegisterEventHandler(
        event_handler=OnProcessExit(
            target_action=spawn_entity,
            on_exit=[diff_drive_spawner, joint_broad_spawner],
        )
    )

    return LaunchDescription([
        declare_use_sim_time_cmd,
        declare_params_file_cmd,
        rsp,
        joystick,
        twist_mux,
        gazebo,
        spawn_entity, 
        delayed_spawners, 
    ])
