ainnajib2002/superbot_ws/(commit log)

2025-08-29 Add src folder of superbot_ws
    [camera.xacro, celah_3.csv, celah_6p1.csv, celah_p2.csv, coba1.csv, coba2.csv, coba3.csv, coba4.csv]
2025-08-29 Update requirements.txt
    add appriltag and kalman filter
2025-08-29 add navigation2 custom
    [KinematicParams.cfg, common_properties.urdf, dump_params_default.txt, dump_params_error.txt, dump_params_help.txt, dump_params_md.txt, dump_params_md_verbose.txt, dump_params_multiple.txt]
